Intelligent-Computing-Research-Group/PolymorPIC/Figures/rtl_view_llc.png

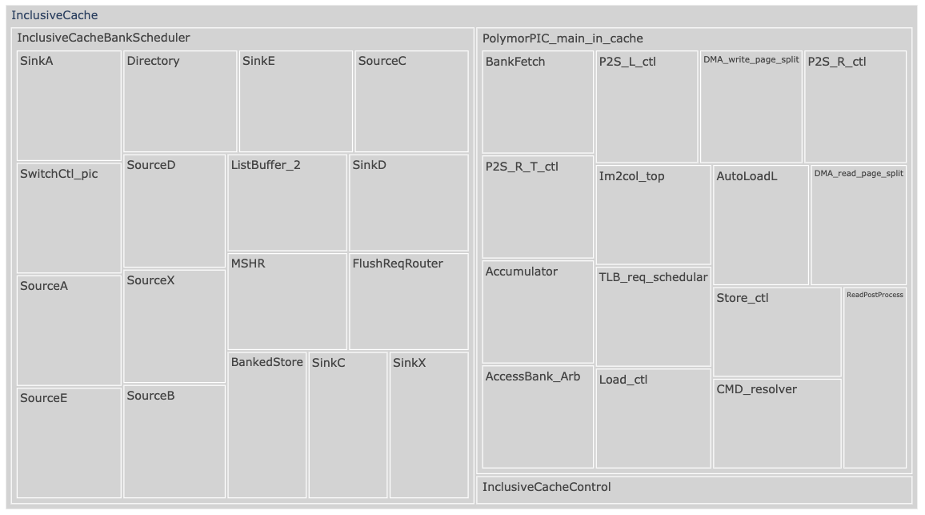
Figures/rtl_view_llc.png
