Intelligent-Computing-Research-Group/PolymorPIC/Figures/rtl_view_polymorpic_main.png

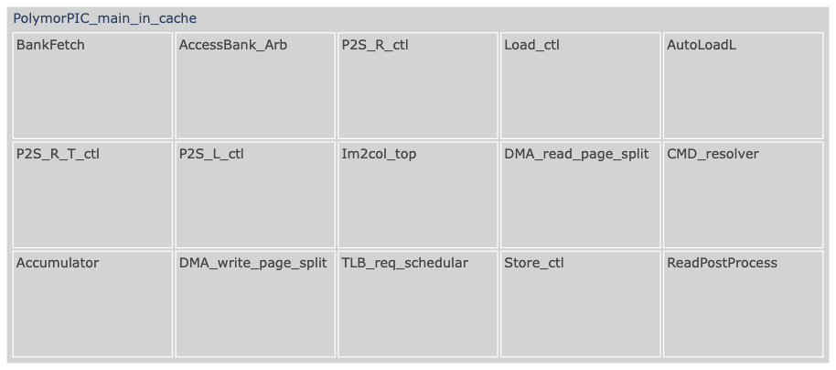
Figures/rtl_view_polymorpic_main.png
