Intelligent-Computing-Research-Group/PolymorPIC/Figures/zcu102_pmod.png

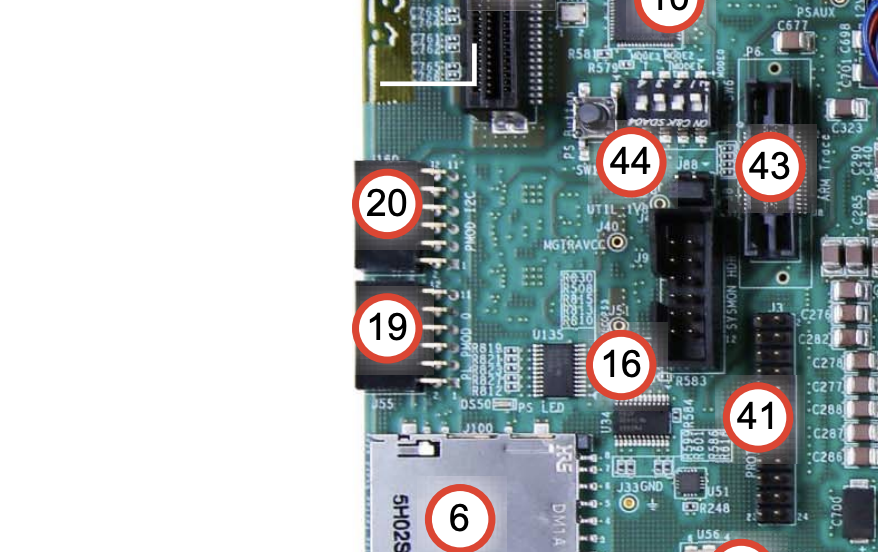
Figures/zcu102_pmod.png
