Intelligent-Computing-Research-Group/PolymorPIC/Chipyard/benchmarks/ACC_test/data.h

#ifndef DATA_H
#define DATA_H
#include <stdint.h>


uint32_t a1_srcMat_0[1024] = {
0xf2cd7dea,0x2f8ec8e2,
0x1888757a,0x2d9eb4de,
0xdfc5ad44,0x20cf693f,
0x635129a3,0xbfc2c5dd,
0xe4ad8aad,0xa56bd175,
0x5bfd8d4a,0x4ae36172,
0xf66f5189,0xdeee5db7,
0xb3ffaa3,0x7d851d8f,
0x2d0446e4,0xde126bfc,
0x87303071,0xda2ebe7f,
0xa6caa0e6,0x8590daec,
0x4e3376b8,0x3183244a,
0xdb954179,0xf997a839,
0xfda12ce4,0xcfc29013,
0x531b82de,0xfca798b,
0x518f0d83,0xf8178f3c,
0x6db1835f,0xb5668066,
0x976991d0,0x4a1e5cb3,
0x8f661e01,0xdb26fcf9,
0xe51580f3,0x83564d99,
0x9c73aab2,0x6446ae06,
0x9a92454,0xf32df351,
0x4e34f745,0xd049fc82,
0x54a61850,0x77ef2b2f,
0x70195abc,0x9fc4527c,
0xf8aaa9ee,0xf677c48c,
0x5e7af58c,0xaf7e8fad,
0x84bde552,0x95d9f00d,
0xc25a3df6,0x8f82eb77,
0x5058a48e,0xc48d78aa,
0x14443682,0x953548ae,
0x3d60c33,0xb99f9bc3,
0xd56a1554,0x73aea754,
0x5bee54d8,0x5abda185,
0xbae6aca7,0x37c2b1d2,
0xcf1ea8e4,0xe5f06234,
0xd7a2c2bf,0x6a1c7bb7,
0x1172b501,0xf3ce7e58,
0xaee60fd,0x7aade1a9,
0x3057acee,0x7e867f4b,
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
};



uint32_t a1_srcMat_1[1024] = {
0x8d379a1b,0x272ae6cd,
0xe11a1205,0x4c015c75,
0xc6f1d9ab,0x5b103d54,
0x39bc200,0x13148432,
0xa0c890c1,0xc9fc6488,
0x3b925cc1,0xa7315c27,
0xfc4415ca,0x59c8fa66,
0x35466528,0x86546aae,
0x8e23eb29,0x8d33e3bc,
0x822dd096,0xd51a674b,
0xccdde6af,0x1b915764,
0x7698216e,0xc8827622,
0x1cd22e54,0xcd397a8f,
0x273da2da,0x60cef02a,
0x89001fab,0x29c00019,
0x4feded2,0x9485a8e,
0x58b7ae21,0x5a55c07b,
0xb642796d,0x56543d19,
0xa69ded7,0xe38dda40,
0x688ef4a,0x84381c6,
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
0x9b53e1c6,0x1346fa50,
0x1c979957,0x24afcf51,
0xd28ad11c,0xafdc5ec7,
0x855840ee,0x5a9afb6b,
0xb1bba6fa,0x1816e80a
};


uint32_t a2_resMatOut[32];
uint16_t a2_srcArrayID_list[4] = {64,68,72,76};
uint32_t* a2_srcArray_content[4] = {a2_srcMat_0,a2_srcMat_1,a2_srcMat_2,a2_srcMat_3};

#endif
