Intelligent-Computing-Research-Group/PolymorPIC/Chipyard/benchmarks/ACC_test/config.h

#ifndef CONFIG_H
#define CONFIG_H

#define _32b_ 1
#define _16b_ 0


// ########## testID:a1 configurations ############

int a1_len_64b = 512;
int a1_srcArrayID = 32;
int a1_srcNum = 5;
int a1_destArrayID = 20;
bool a1_bitWidth = _32b_;


// ########## testID:a2 configurations ############

int a2_len_64b = 16;
int a2_srcArrayID = 64;
int a2_srcNum = 4;
int a2_destArrayID = 240;
bool a2_bitWidth = _32b_;

#endif
