Intelligent-Computing-Research-Group/PolymorPIC/(notices)

Notices in the files:
README.md:
License: MuLan PSL 2.0
